pe1mew/TTNApeldoornDustSensor/Media/highres_466870968.jpeg

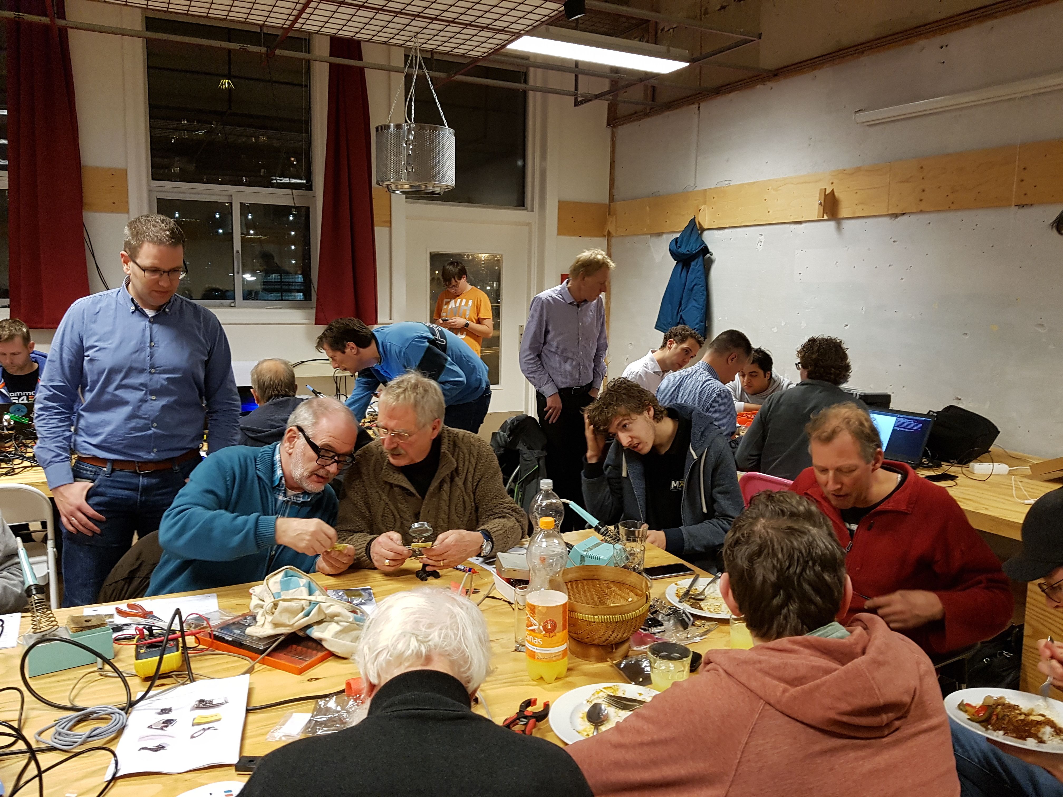
Media/highres_466870968.jpeg
