pe1mew/TTNApeldoornDustSensor/Media/DRWmXMgWAAA1BLA.jpg large.jpg

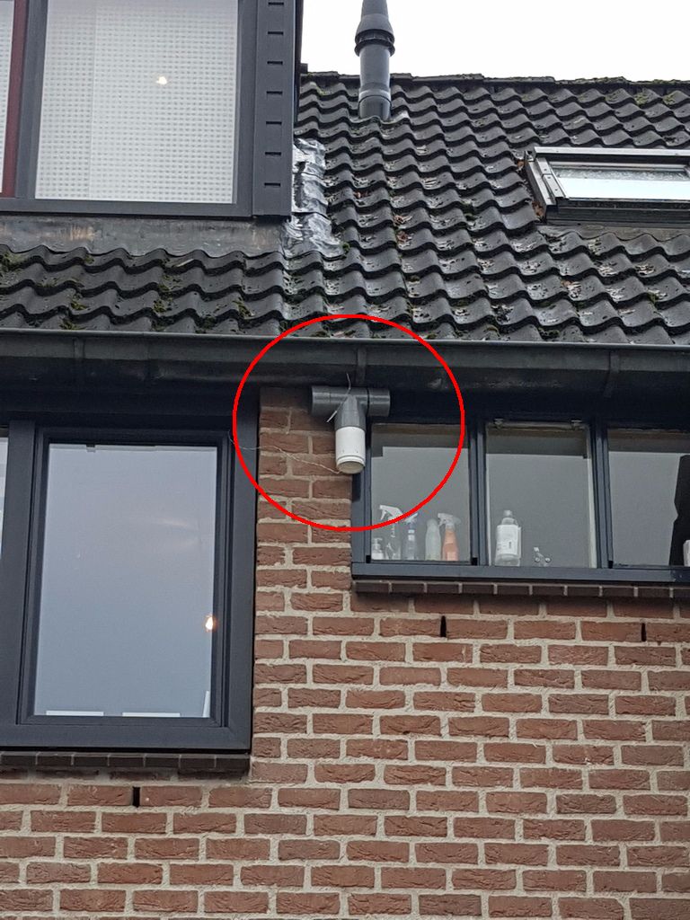
Media/DRWmXMgWAAA1BLA.jpg large.jpg
