pe1mew/TTNApeldoornDustSensor/README.md

# TTNApeldoornDustSensor
Dust sensor project of TTN Apeldoorn December 2017
