pe1mew/TTNApeldoornDustSensor/Hardware/Top-pcb.png

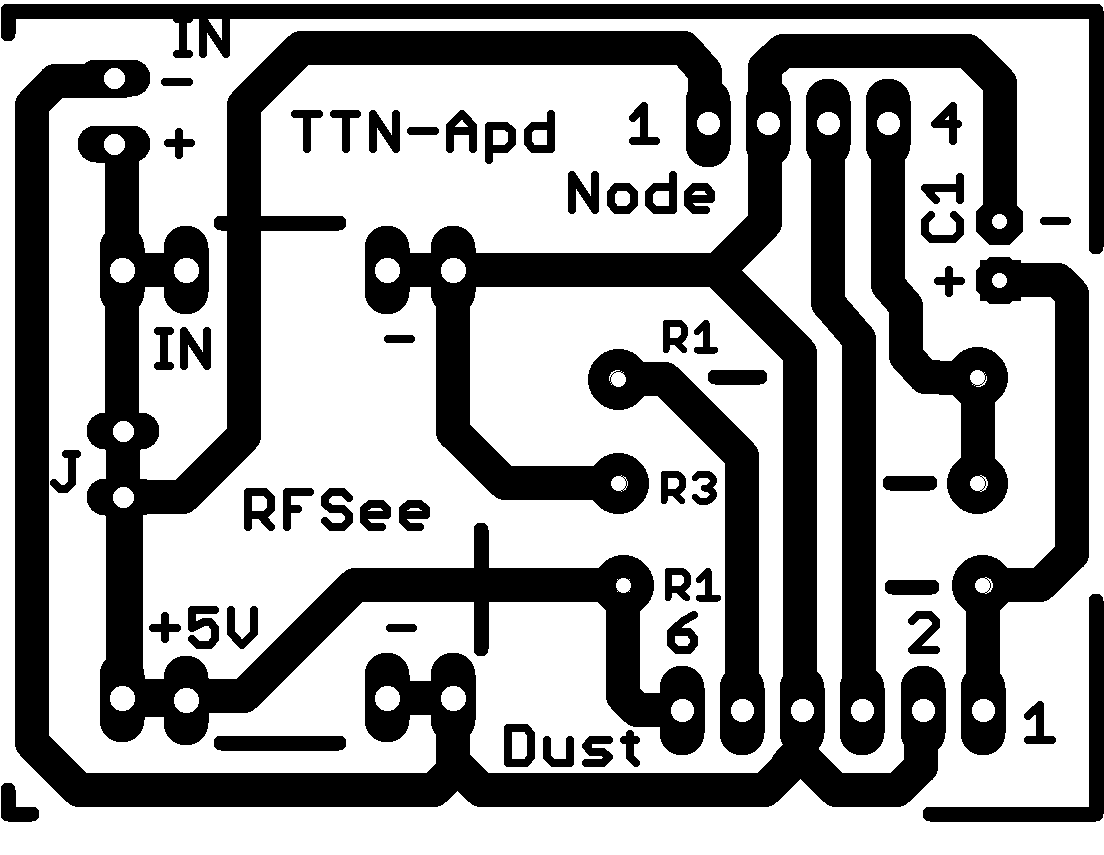
Hardware/Top-pcb.png
