pe1mew/TTNApeldoornDustSensor/Media/highres_466870927.jpeg

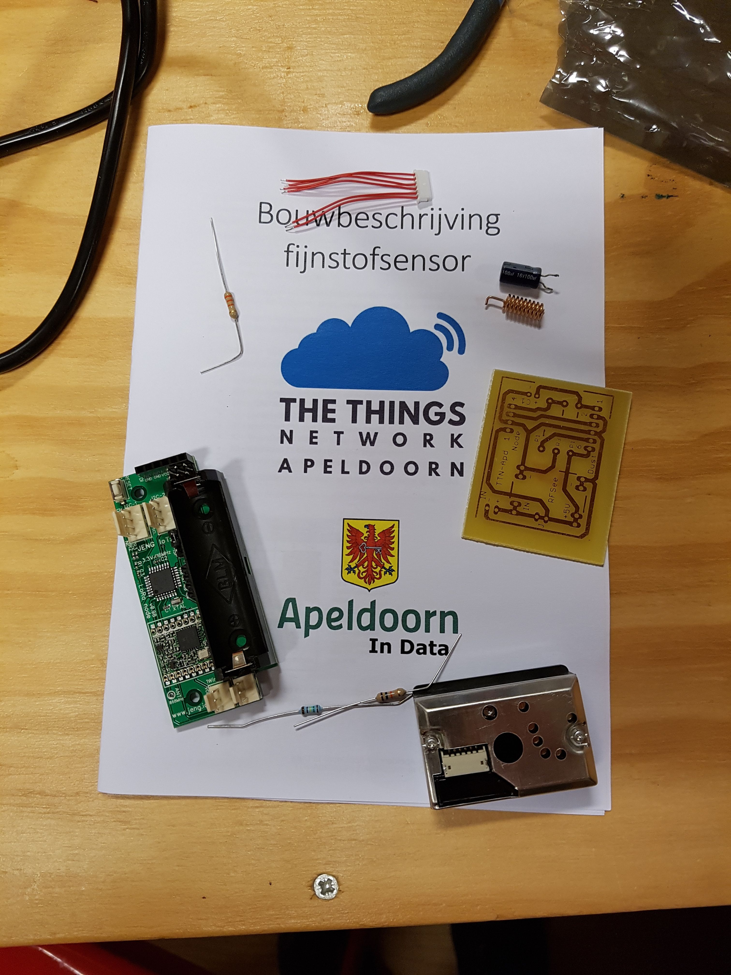
Media/highres_466870927.jpeg
