pe1mew/TTNApeldoornDustSensor/Hardware/ComponentLayout.png

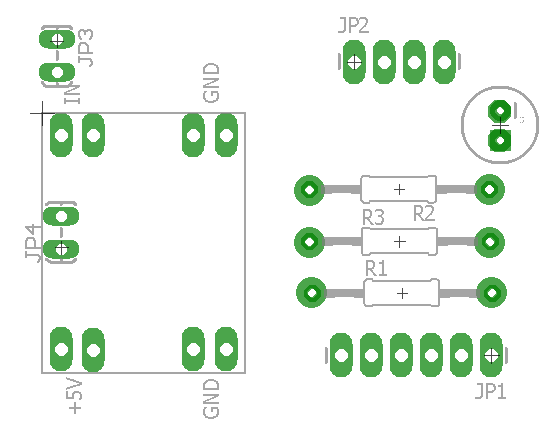
Hardware/ComponentLayout.png
